SaltyBlackDog300/AsianBros_-ObstaclesDectection/images/day1_planning.jpg

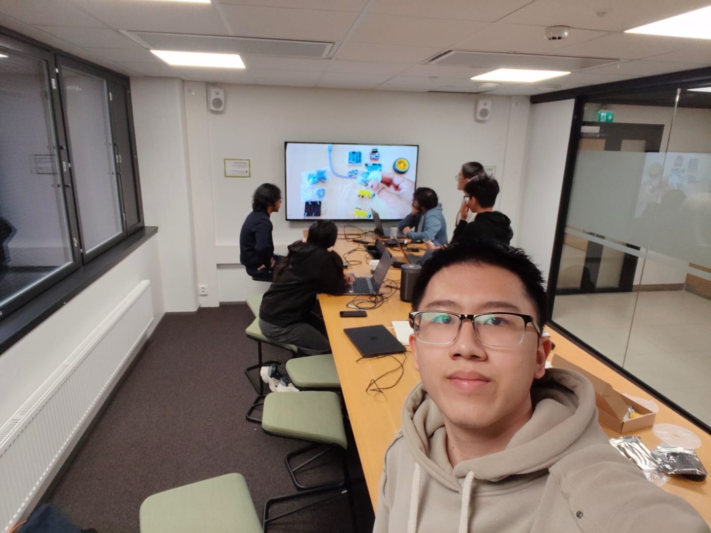
images/day1_planning.jpg
