SaltyBlackDog300/AsianBros_-ObstaclesDectection/images/day1_team.jpg

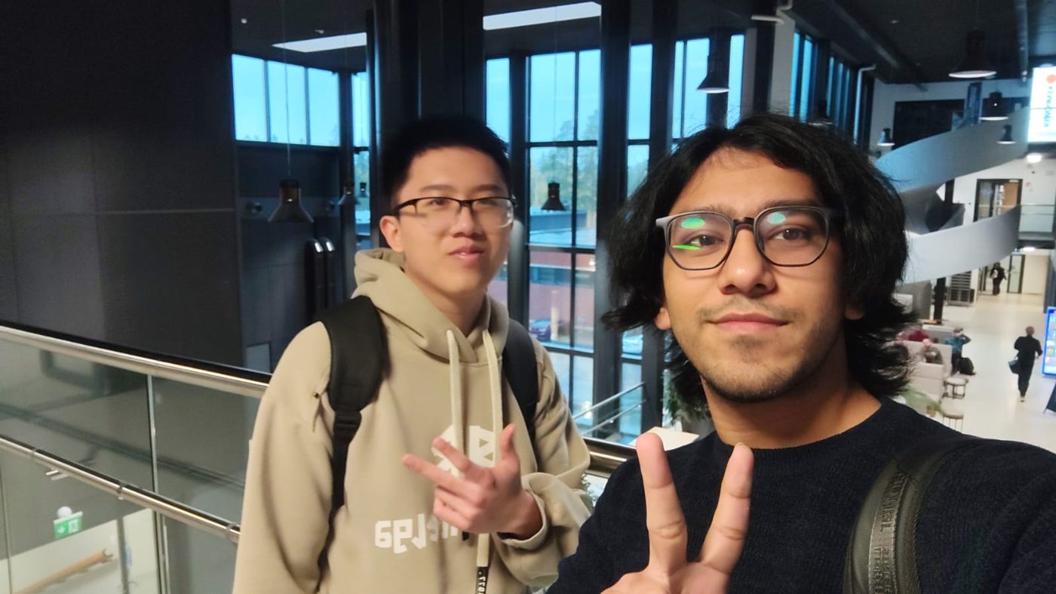
images/day1_team.jpg
