SaltyBlackDog300/AsianBros_-ObstaclesDectection/tools/sensor_test/sensor_test.ino

const int TRIG = 11, ECHO = 12;

void setup() {
  Serial.begin(9600);
  pinMode(TRIG, OUTPUT);
  pinMode(ECHO, INPUT);
}

void loop() {
  digitalWrite(TRIG, LOW);  delayMicroseconds(2);
  digitalWrite(TRIG, HIGH); delayMicroseconds(10);
  digitalWrite(TRIG, LOW);
  unsigned long us = pulseIn(ECHO, HIGH, 30000UL);
  Serial.println(us == 0 ? -1 : (long)(us / 58));
  delay(200);
}
