SaltyBlackDog300/AsianBros_-ObstaclesDectection/(commit log)

2026-10-11 Drive wheels with steppers again and match the final wiring
2026-10-11 README: describe all modes and the current file layout
